AMaximino/projeto-labdig/modelagem/saida/gabarito_tampa.pdf

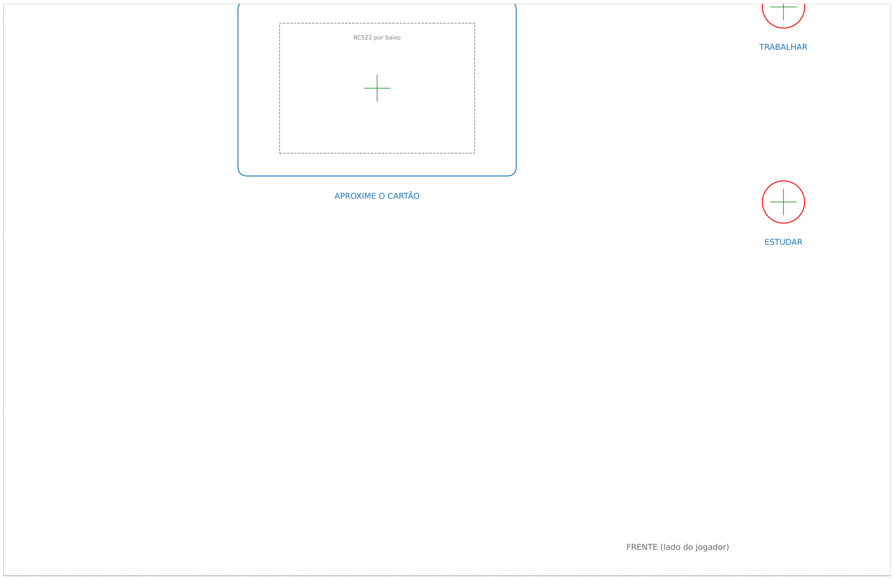
[picture p2: figure]
TRABALHAR; ESTUDAR; APROXIME O CARTÃO; RC522 por baixo; FRENTE (lado do jogador)

### INVESTIR

### RESGATAR

Gabarito da TAMPA folha 1/4 (coluna 1, linha 1). Imprimir em TAMANHO REAL (100%). Sobrepor 10 mm entre folhas.

régua: deve medir 100 mm

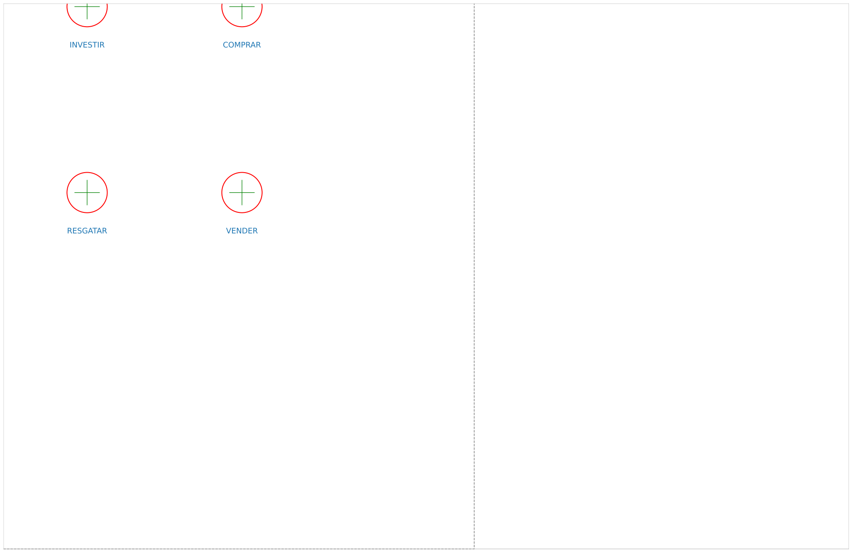
[picture p3: figure]
INVESTIR; RESGATAR; COMPRAR; VENDER

Gabarito da TAMPA folha 2/4 (coluna 2, linha 1). Imprimir em TAMANHO REAL (100%). Sobrepor 10 mm entre folhas.

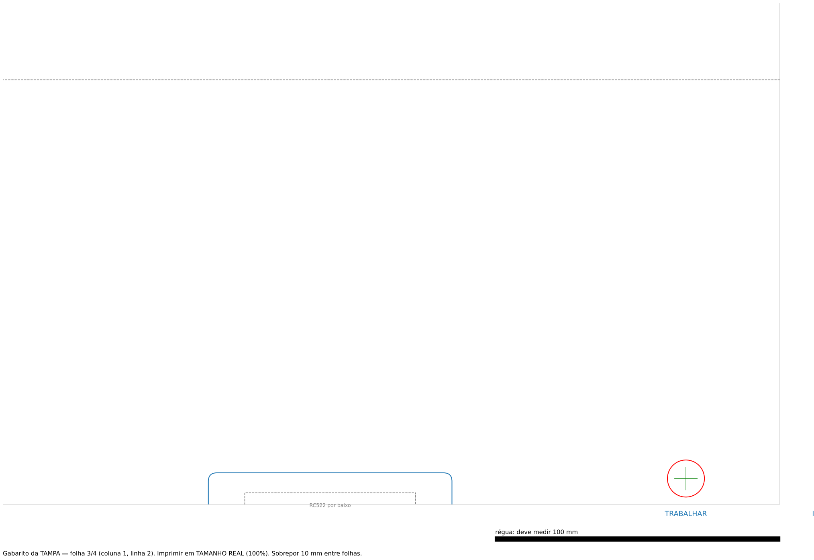
[picture p4: figure]
TRABALHAR; RC522 por baixo

### INVESTIR

Gabarito da TAMPA | folha 3/4 (coluna 1, linha 2). Imprimir em TAMANHO REAL | (100%). Sobrepor 10 mm entre folhas.

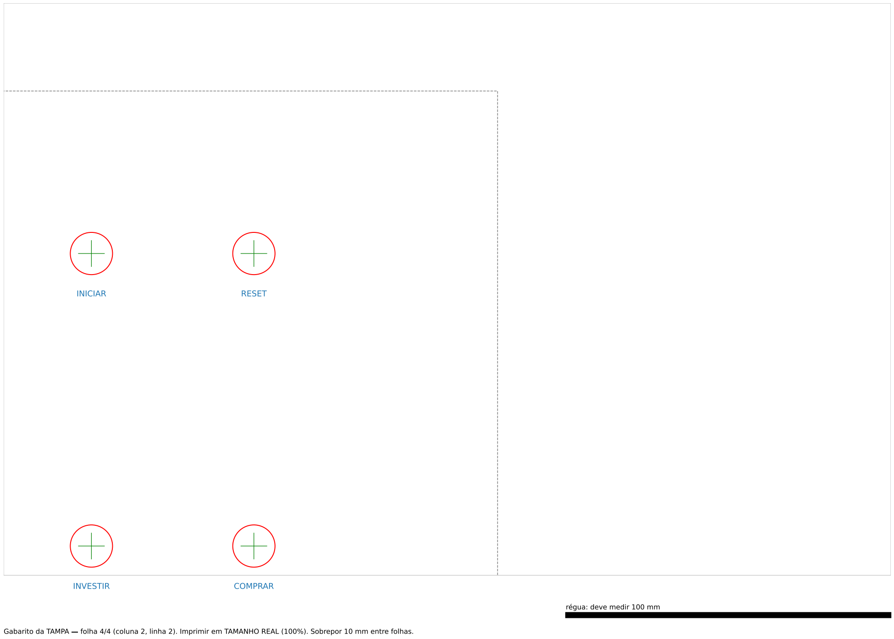
[picture p5: figure]
INVESTIR; COMPRAR; INICIAR; RESET

Gabarito da TAMPA folha 4/4 (coluna 2, linha 2). Imprimir em TAMANHO REAL (100%). Sobrepor 10 mm entre folhas.
