AMaximino/projeto-labdig/front/images/WhatsApp Image 2026-11-02 at 20.14.32.jpeg

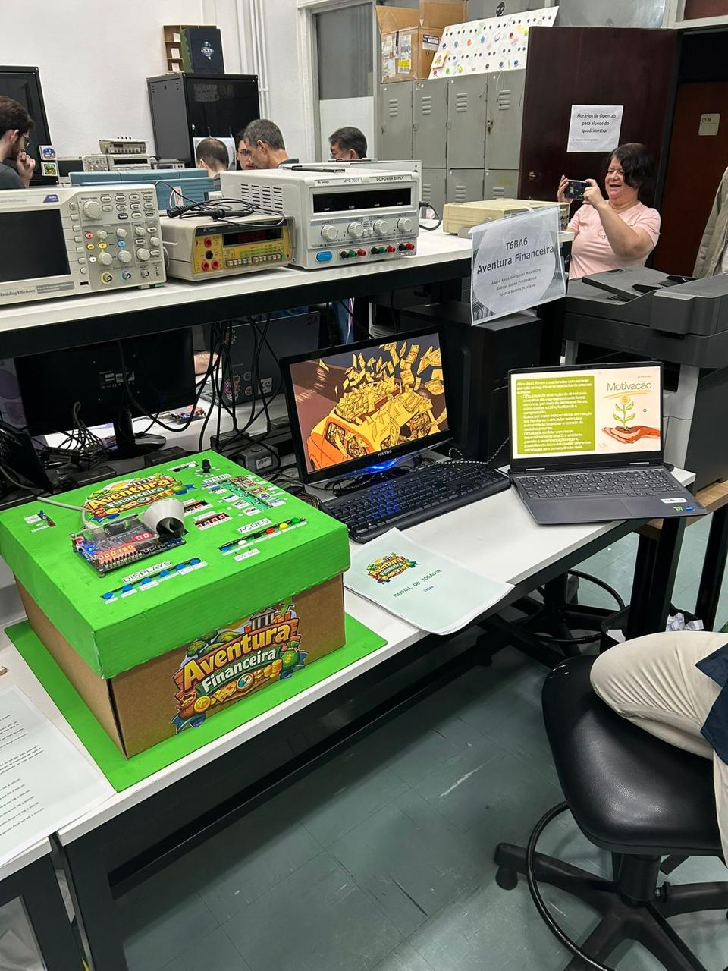
front/images/WhatsApp Image 2026-11-02 at 20.14.32.jpeg
