AMaximino/projeto-labdig/images/arquitetura-hardware.png

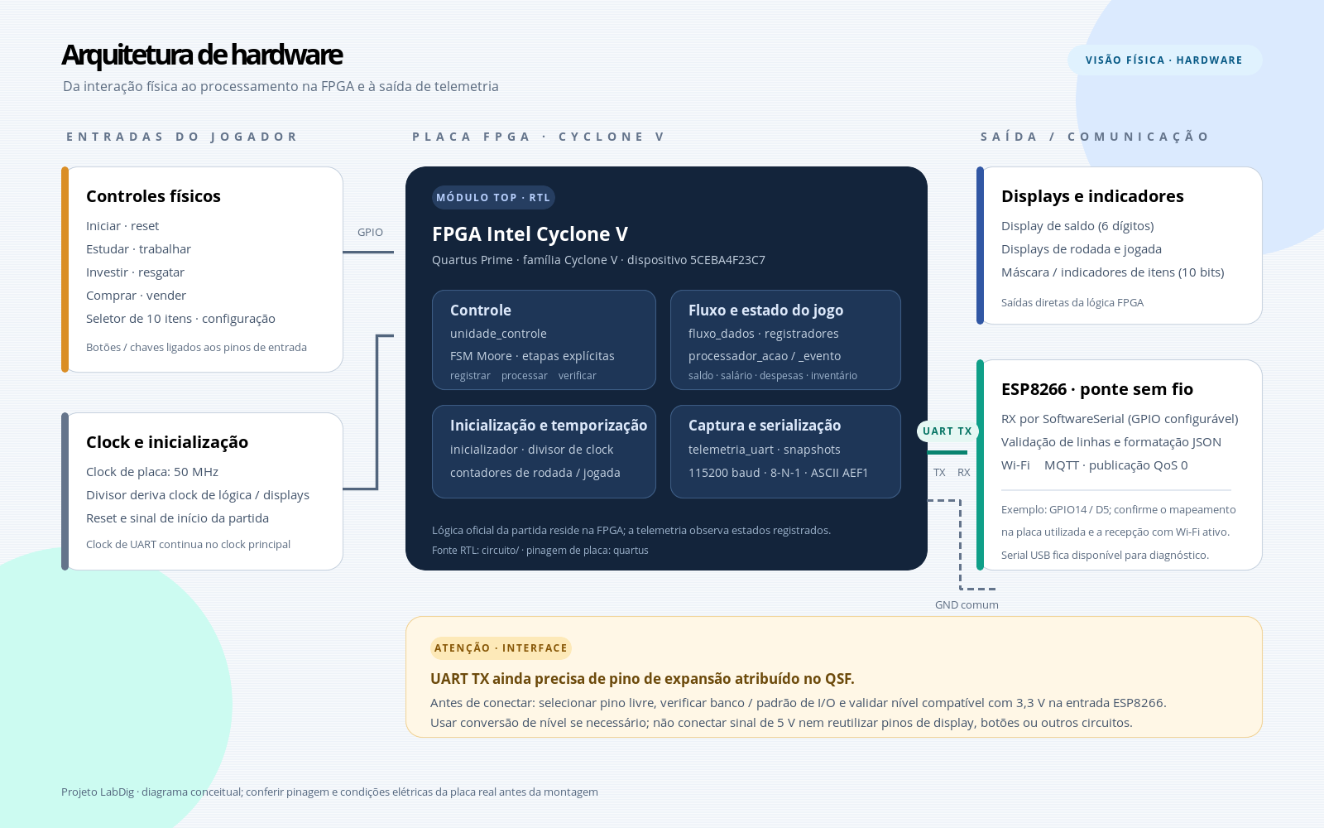
images/arquitetura-hardware.png
