AMaximino/projeto-labdig/images/integracao-software-hardware.png

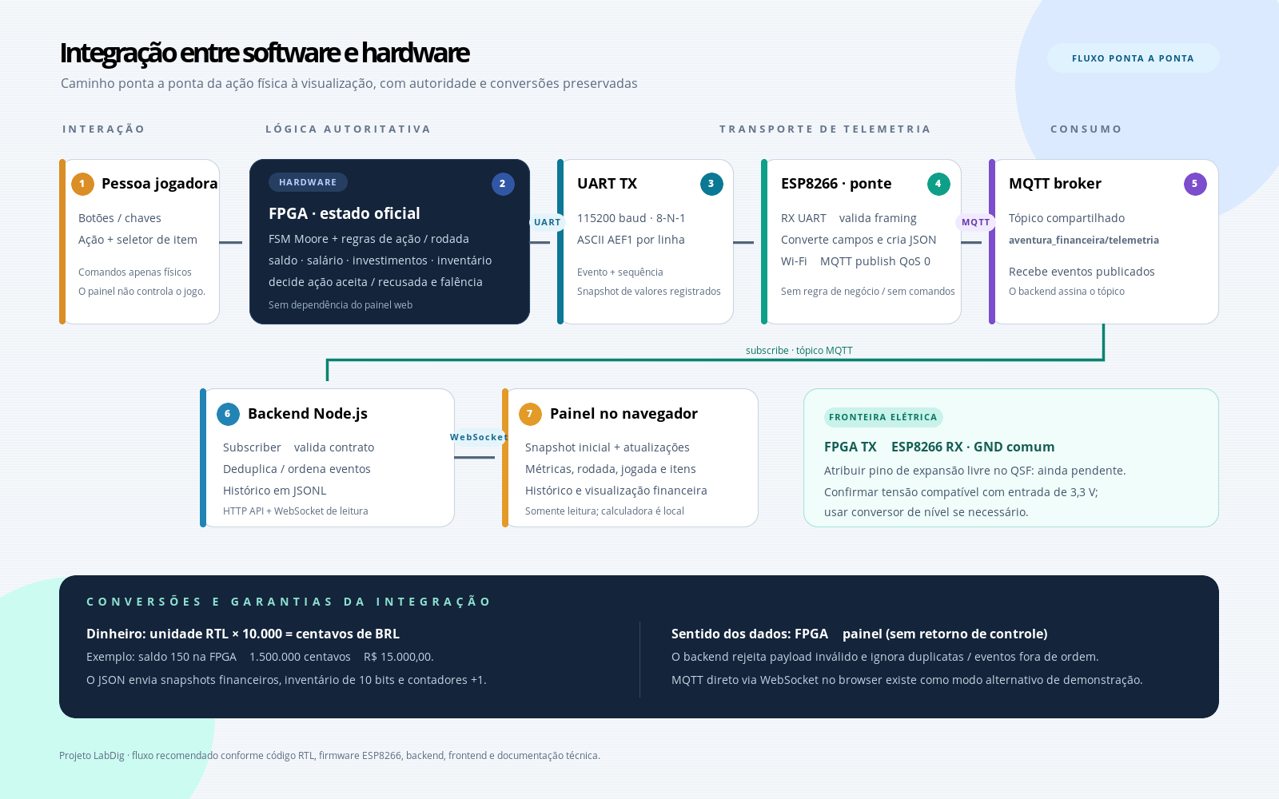
images/integracao-software-hardware.png
