AMaximino/projeto-labdig/modelagem/saida/gabarito_traseira.dxf

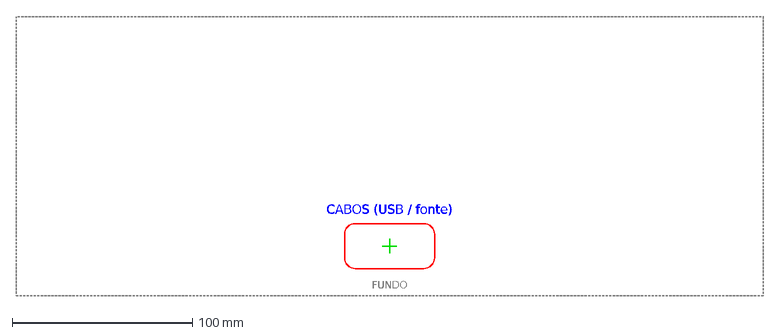
[picture p75: CAD file, 2026-11-11]
modelagem/saida/gabarito_traseira.dxf
CABOS (USB / fonte)
FUNDO
