AMaximino/projeto-labdig/modelagem/saida/caixa.step

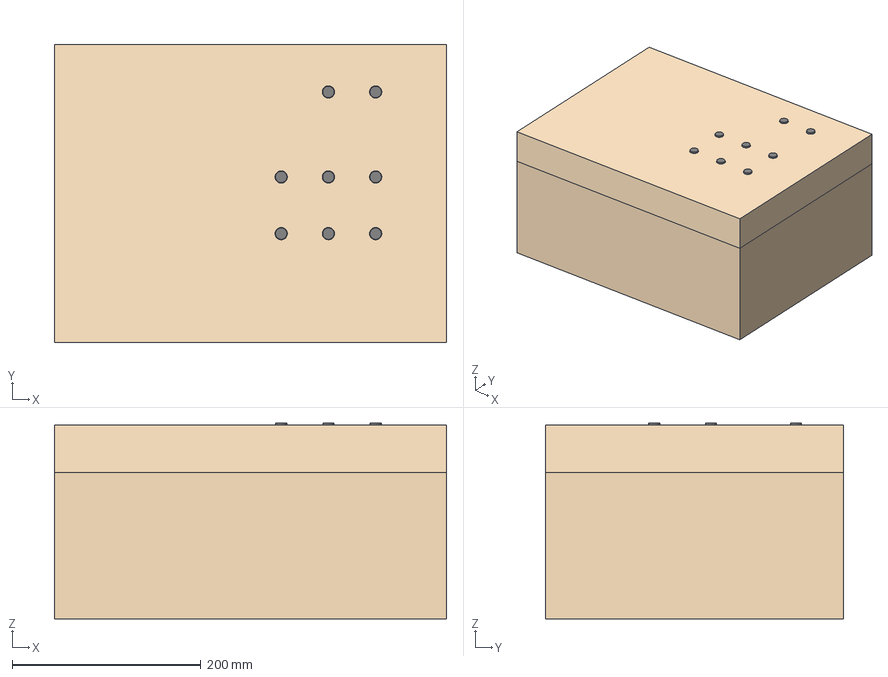
[picture p76: CAD file, 2026-11-11]
modelagem/saida/caixa.step
415.0 x 315.0 x 207.0 mm
corpo
tampa
botoes
rc522
de0_cv
esp32
