AMaximino/projeto-labdig/modelagem/saida/gabarito_tampa.dxf

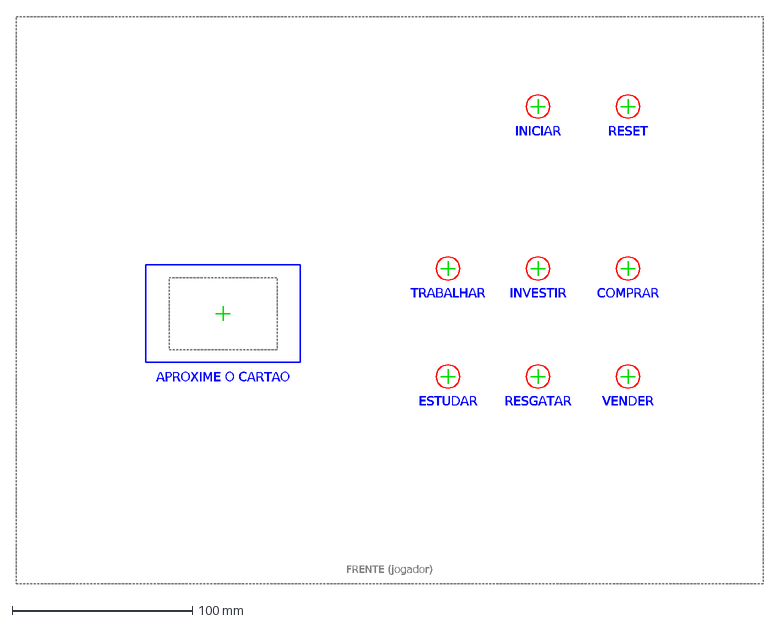
[picture p77: CAD file, 2026-11-11]
modelagem/saida/gabarito_tampa.dxf
TRABALHAR
ESTUDAR
INVESTIR
RESGATAR
COMPRAR
VENDER
INICIAR
RESET
APROXIME O CARTAO
FRENTE (jogador)
