AMaximino/projeto-labdig/(list of files, cad)

Other CAD files:
modelagem/saida/caixa.stl
