AMaximino/projeto-labdig/docs/fotos/montagem-3.jpeg

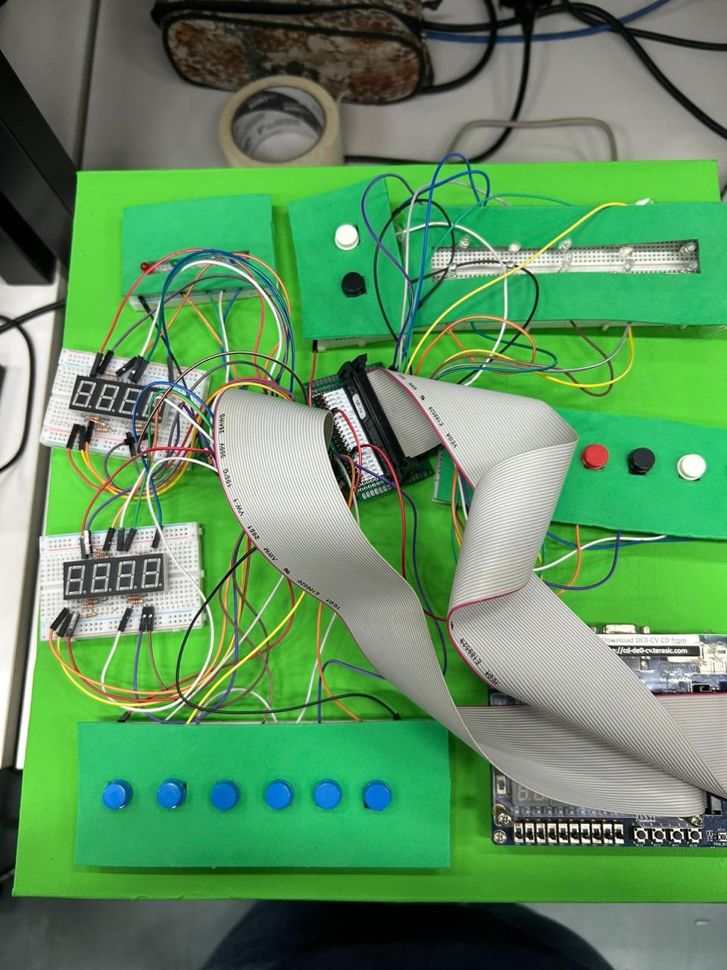
docs/fotos/montagem-3.jpeg
