AMaximino/projeto-labdig/esp/tools/conectar_wifi/conectar_wifi.ino

#include <ESP8266WiFi.h>

#define ssid "iPhone de Sophia"
#define password "sophiasophia"

void setup() {
  // put your setup code here, to run once:
  WiFi.mode(WIFI_STA);
  WiFi.begin(ssid, password);

  Serial.begin(115200);

  while (WiFi.status() != WL_CONNECTED) {
    delay(500);
    Serial.print(".");
  }

  Serial.println("");
  Serial.print("Connected to ");
  Serial.println(ssid);
  Serial.print("IP Address: ");
  Serial.println(WiFi.localIP());
}

void loop() {
  // put your main code here, to run repeatedly:
}
