AMaximino/projeto-labdig/(commit log)

2026-03-13 arquivos para o projeto
2026-03-13 Unidade de controle, versao inicial
2026-03-13 Adiciona módulo de conversão para saída em display hex de 4 digitos
2026-03-13 inicio fd e circuito
2026-03-15 atualizacoes na logica do display de 6 digitos; inicio da identificacao de acoes
2026-03-17 simplificacao para sintese na semana 1
    mudança contador_163_modo para receber modulo na entrada, além de ser parametrizável. Comntários em algumas partes que serão implementadas posteriormente.
2026-03-17 correções para compilação e criação do projeto no quartus
    [c5_pin_model_dump.txt]
2026-03-17 Adição do pin planner no Quartus
    [c5_pin_model_dump.txt]
2026-03-17 auxílio para simulação com modelsim
2026-03-18 sinais de saida, wires que estavam faltando, melhora do tb1
2026-03-19 primeiro commit para a semana 2
2026-03-19 saida de depuracao em display7segmentos para o estado
2026-03-20 commit provisorio para mudança no armazenamento das info do jogador
2026-03-20 negação de entradas para botao pull down
2026-03-22 versão preliminar (apenas um estado de processamento)
2026-03-22 configuracao de display de 6 algarismos funcional
2026-03-23 sinal de controle enable do processamento
2026-03-25 saidas provisorias de depuracao, mudança para active low
2026-03-27 prototipo de uc para semana 3
    correção da inicialização de valores
2026-03-27 negar clear contadores e botoes de acao funcionando (nosso botoes)
2026-03-27 display para numeros negativos
2026-03-27 configuracoes e pinagens no devel
    [pinagem_com_nossos_botoes.csv]
2026-03-27 semana dois funcionando, pinagem, botoes de acao, negativo, reinicializar valores. Configurado para 3 jogadas, 8 rodadas
2026-03-27 adiciona display de 7 segmentos que converte para bcd e amostra o valor da jogada/rodada e o limite max
2026-03-28 modificacao para comprar item no processador de acao, modificacao no circuito para suportar selecionar item (usando hot-one), testbench. Está compilando, falta verificar a simulação cuidadosamente
2026-03-28 venda implementada. Tb otimizado para testar compra e venda. Run1.do atualizado para depuracao
2026-03-28 logica combinatoria para processamento; mudanças UC e FD; atualizacao de valores no fim de rodada/jogada
2026-03-31 outputs para display bcd e inicialização correta dos itens
    Modificações não testadas
2026-04-01 rodada e botoes iniciar e reset
    [circuito_jogo_financeiro.v, i2s_master_clock_gen.v]
2026-04-02 adiciona qar do relato 3 e altera i2s_master_clock DENTRO da simulação para deixar em verilog
2026-04-06 balanceamento, atualizacao de historico de gastos e de despesas
2026-04-07 Adiciona qar e adiciona o i2s para ser em verilog
2026-04-07 despesa pode terminar jogo
    arquivos de simulação adaptados para simular clock da FPGA (50 MHz) e clock_divider traduzido para verilog para facilitar simulação.
2026-04-08 correção limite de rodadas
2026-04-08 reset também zera displays antes de iniciar
    [unidade_controle.v]
2026-04-22 desligar displays ao resetar
    mudança de item
    [circuito_jogo_financeiro.v, display_bcd_4dig_cc.v, processador_acao.v, unidade_controle.v]
2026-04-22 correcoes na UC e no reset do display
    [display_bcd_4dig_cc.v, unidade_controle.v]
2026-04-27 deleção de arquivos
2026-11-03 Imagens de arquitetura
2026-11-04 arquivos de configuração de esp8266
2026-11-10 cria testes e imagem da máquina de estados
2026-11-10 arquivos de teste para esp32
2026-11-10 volta perder o jogo
2026-11-10 adiciona esp32 para funcionar com o circuito e integração com o módulo rfid
2026-11-10 testes uart
